wagiminator/ATtiny13-VolumeAdjuster/hardware/VolumeAdjuster_BOM.tsv

ID | Name | Designator | Footprint | Quantity | Manufacturer Part | Manufacturer | Supplier | Supplier Part | Price
1 | 10u | C1,C3,C4,C7 | C_0603_S | 4 | CL10A106MA8NRNC | SAMSUNG | LCSC | C96446 | 0.023
2 | 100n | C2,C6,C8 | C_0603_S | 3 | CC0603KRX7R9BB104 | YAGEO | LCSC | C14663 | 0.003
3 | 4u7 | C5 | C_0603_S | 1 | CL10A475KA8NQNC | SAMSUNG | LCSC | C69335 | 0.021
4 | BAT | CN1 | CONN-SMD_2P_PH2.0_SPWB | 1 | PH2.0-2P | BOOMELE | LCSC | C64658 | 0.053
5 | 4148 | D1 | SOD_323 | 1 | 1N4148WS | FUXINSEMI | LCSC | C908249 | 0.01
6 | CHARGE | LED1 | LED_0603_S | 1 | KT-0603R | KENTO | LCSC | C2286
7 | IR333-A | LED2 | LED-3MM/2.54 | 1 | IR333-A | Everlight Elec | LCSC | C264290 | 0.062
8 | ELECTRET | Q1 | 9.7ELECTRET | 1 | ?
9 | 3904 | Q2 | SOT-23-3_W | 1 | 2n3904S-RTK/PS | KEC | LCSC | C18536 | 0.015
10 | 10k | R1,R2,R5,R8 | R_0603_S | 4 | 0603WAF1002T5E | UniOhm | LCSC | C25804 | 0.001
11 | 100k | R3 | R_0603_S | 1 | 0603WAF1003T5E | UniOhm | LCSC | C25803 | 0.001
12 | 1k | R4,R7,R11 | R_0603_S | 3 | 0603WAF1001T5E | UniOhm | LCSC | C21190 | 0.001
13 | 4k7 | R6 | R_0603_S | 1 | 0603WAF4701T5E | UniOhm | LCSC | C23162 | 0.001
14 | 5k1 | R9,R10 | R_0603_S | 2 | 0603WAF5101T5E | UniOhm | LCSC | C23186 | 0.001
15 | 10K | R12 | RES-ADJ-TH_3P-L9.5-W9.5-P2.54-BR-BS | 1 | 3386P-1-103TLF | BOURNS | LCSC | C116302 | 1.613
16 | POWER | SW1 | SW-SMD_SS-1290L-GLL-1.5MM | 1 | SS-1290L-GL L=1.5mm | RI SHENG | LCSC | C695418 | 0.102
17 | ATtiny13A | U1 | SOP-8_150MIL | 1 | ATTINY13A-SSU | MICROCHIP | LCSC | C14075 | 2.048
18 | LMV321 | U2 | SOT-23-5 | 1 | LMV321 | PJ(Pingjingsemi) | LCSC | C686637 | 0.069
19 | MCP73831T | U3 | SOT-23-5 | 1 | MCP73831T-2ATI/OT | MICROCHIP | LCSC | C14879 | 1.056
20 | USB-TYPE-C-6PIN | USB1 | USB-C-SMD-6P | 1 | TYPE-C-31-M-17 | Korean Hroparts Elec | LCSC | C283540 | 0.194
