wagiminator/ATtiny13-VolumeAdjuster/hardware/VolumeAdjuster_schematic.pdf

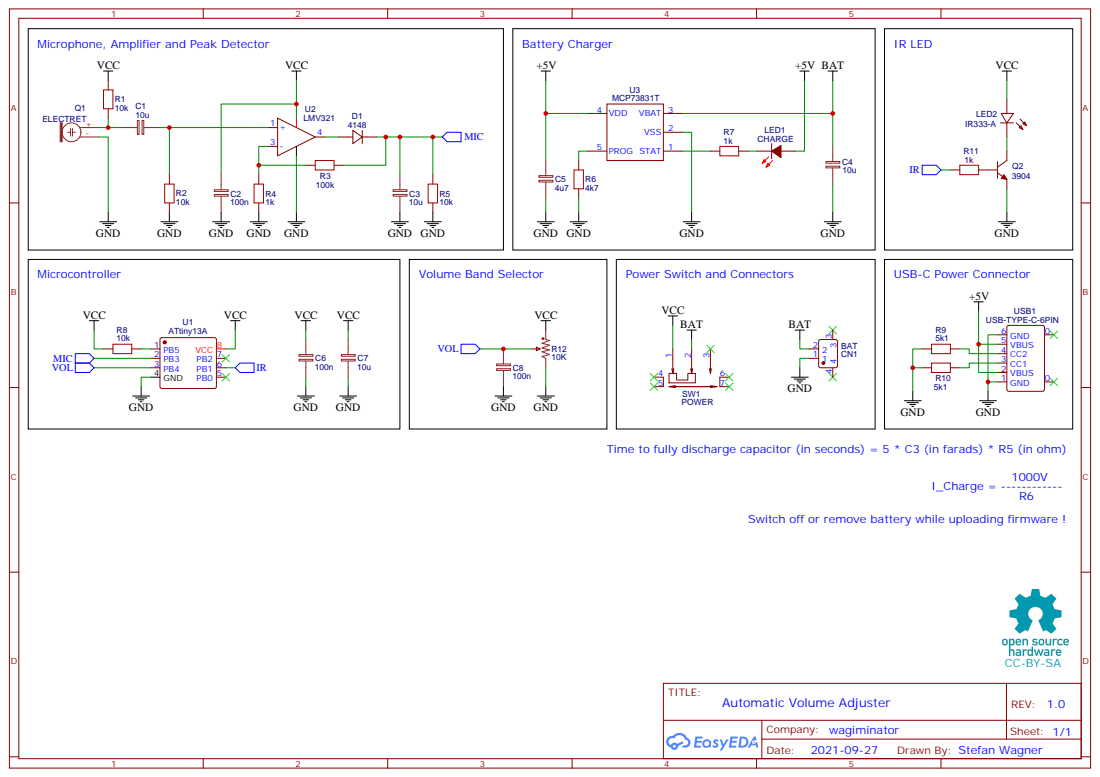
[picture p6: page 1]

Power Switch and Connectors

Time to fully discharge capacitor (in seconds) = 5 * C3 (in farads) * R5 (in ohm)

Switch off or remove battery while uploading firmware !

Drawn By: Stefan Wagner
